Weepfrog/Adaptive-Arm/README.md

This project was created for Northeastern University's Enabling Engineering Program

This is an unfinished project and as much documentation as posible is provided here
This includes PDFs outlining the project, the setup, and the assembly of the mechanism
It also includes a document outlining the issues of the project
