Weepfrog/Adaptive-Arm/(commit log)

2024-07-18 added motor turn
2024-07-22 Updated button logic
2024-07-22 correced button logic
